tyrelkostyk/GE495-electrical/kicad_project/digitizer/digitizer.kicad_pcb

## KiCad design kicad_project/digitizer/digitizer.kicad_pcb (2022-02-17)

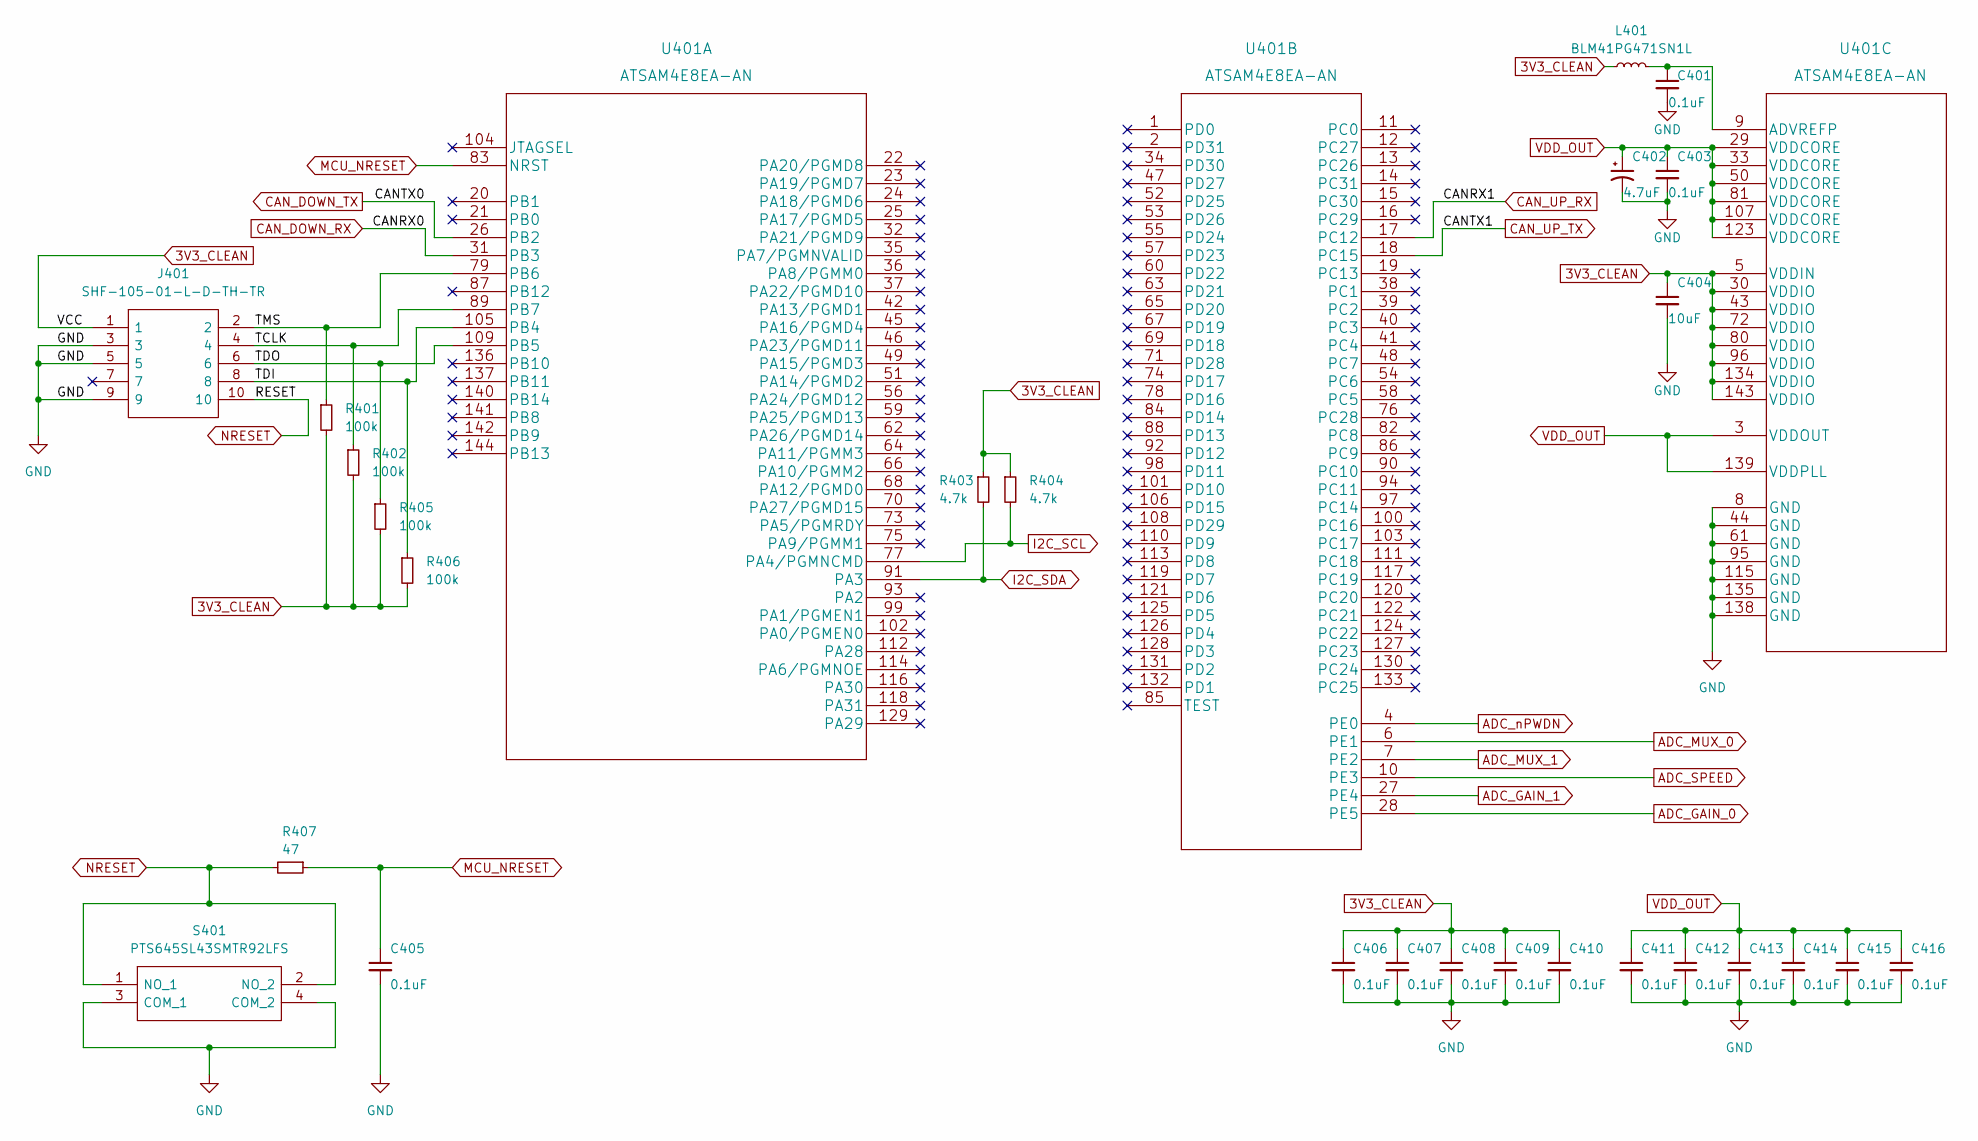
[picture p5: schematic MCU.kicad_sch]

Parts:
C401, C403, C405, C406, C407, C408, C409, C410, C411, C412, C413, C414, C415, C416: 0.1uF; C_0805_2012Metric_Pad1.18x1.45mm_HandSolder
C402: 4.7uF; C_0805_2012Metric_Pad1.18x1.45mm_HandSolder
C404: 10uF; C_0805_2012Metric_Pad1.18x1.45mm_HandSolder
J401: SHF-105-01-L-D-TH-TR; SHF10501LDTHTR; Mouser Part Number 200-SHF10501LDTHTR
L401: BLM41PG471SN1L; L_1806_4516Metric_Pad1.45x1.90mm_HandSolder
R401, R402, R405, R406: 100k; R_0805_2012Metric_Pad1.20x1.40mm_HandSolder
R403, R404: 4.7k; R_0805_2012Metric_Pad1.20x1.40mm_HandSolder
R407: 47; R_0805_2012Metric_Pad1.20x1.40mm_HandSolder
S401: PTS645SL43SMTR92LFS; Mouser Part Number 611-PTS645SL43SMTR92
U401: ATSAM4E8EA-AN

Connections:
3V3_CLEAN: C404.1, C406.1, C407.1, C408.1, C409.1, C410.1, J401.1, L401.1, R401.2, R402.2, R403.1, R404.1, R405.2, R406.2, U401.5 (VDDIN), U401.30 (VDDIO), U401.43 (VDDIO), U401.72 (VDDIO), U401.80 (VDDIO), U401.96 (VDDIO), U401.134 (VDDIO), U401.143 (VDDIO); also elsewhere on the board
/MCU/TCLK: J401.4, R402.1, U401.89 (PB7)
/MCU/TDI: J401.8, R406.1, U401.105 (PB4)
/MCU/TDO: J401.6, R405.1, U401.109 (PB5)
/MCU/TMS: J401.2, R401.1, U401.79 (PB6)
ADC_GAIN_0: U401.28 (PE5); also elsewhere on the board
ADC_GAIN_1: U401.27 (PE4); also elsewhere on the board
ADC_MUX_0: U401.6 (PE1); also elsewhere on the board
ADC_MUX_1: U401.7 (PE2); also elsewhere on the board
ADC_SPEED: U401.10 (PE3); also elsewhere on the board
ADC_nPWDN: U401.4 (PE0); also elsewhere on the board
CAN_DOWN_RX: U401.31 (PB3); also elsewhere on the board
CAN_DOWN_TX: U401.26 (PB2); also elsewhere on the board
CAN_UP_RX: U401.17 (PC12); also elsewhere on the board
CAN_UP_TX: U401.18 (PC15); also elsewhere on the board
GND: C401.2, C402.2, C403.2, C404.2, C405.2, C406.2, C407.2, C408.2, C409.2, C410.2, C411.2, C412.2, C413.2, C414.2, C415.2, C416.2, J401.3, J401.5, J401.9, S401.3 (COM_1), S401.4 (COM_2), U401.8 (GND), U401.44 (GND), U401.61 (GND), U401.95 (GND), U401.115 (GND), U401.135 (GND), U401.138 (GND); also elsewhere on the board
I2C_SCL: R404.2, U401.77 (PA4/PGMNCMD); also elsewhere on the board
I2C_SDA: R403.2, U401.91 (PA3); also elsewhere on the board
MCU_NRESET: C405.1, R407.1, U401.83 (NRST)
NRESET: J401.10, R407.2, S401.1 (NO_1), S401.2 (NO_2)
unnamed: C401.1, L401.2, U401.9 (ADVREFP)
VDD_OUT: C402.1, C403.1, C411.1, C412.1, C413.1, C414.1, C415.1, C416.1, U401.3 (VDDOUT), U401.29 (VDDCORE), U401.33 (VDDCORE), U401.50 (VDDCORE), U401.81 (VDDCORE), U401.107 (VDDCORE), U401.123 (VDDCORE), U401.139 (VDDPLL)

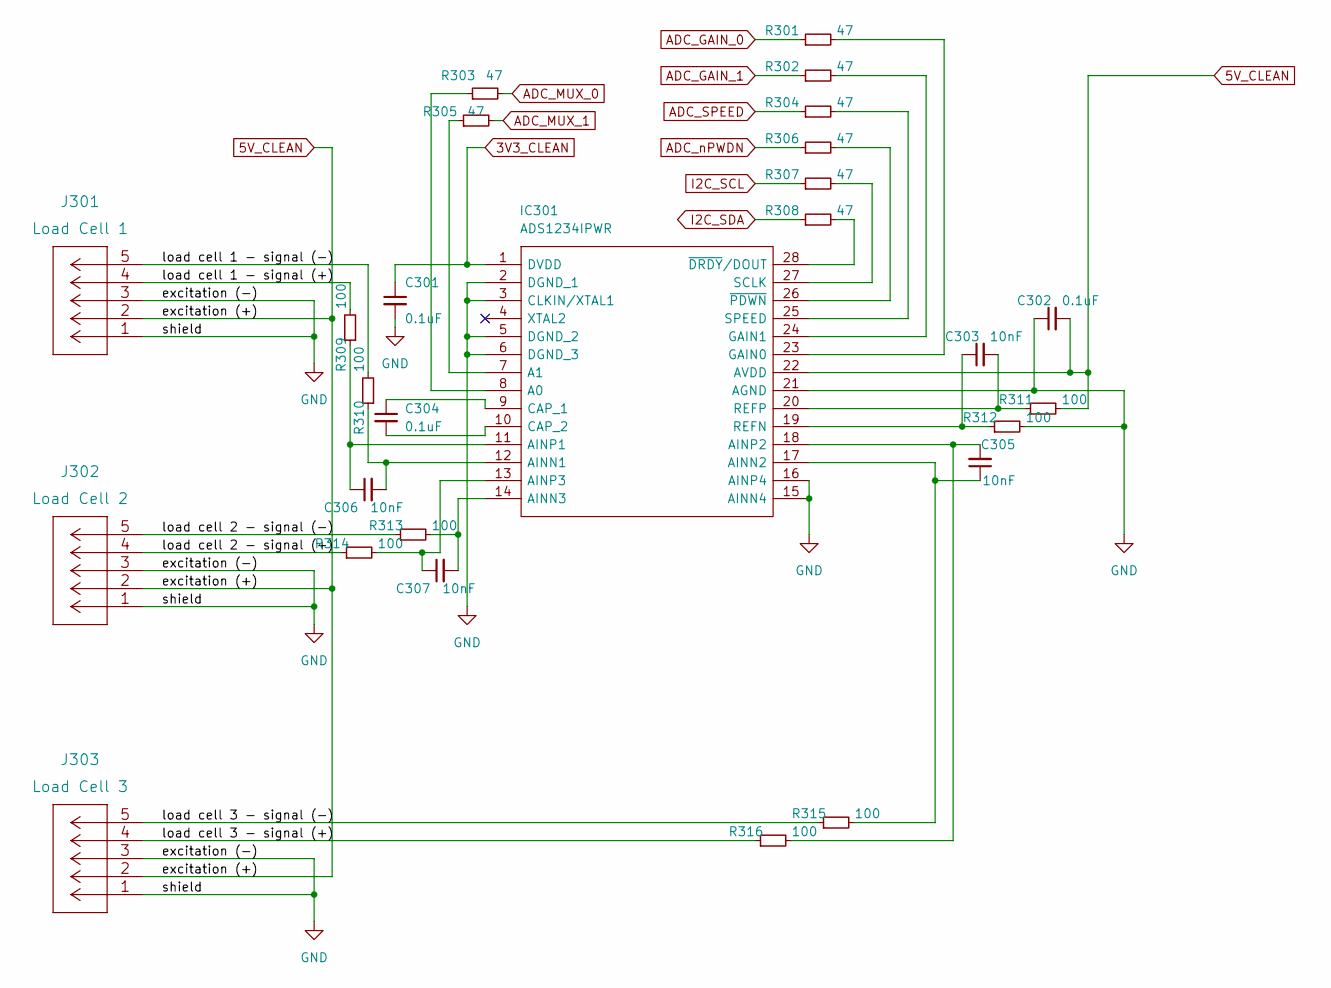
[picture p6: schematic ANALOG.kicad_sch]

Parts:
C301, C302, C304: 0.1uF; C_0805_2012Metric_Pad1.18x1.45mm_HandSolder
C303, C305, C306, C307: 10nF; C_0805_2012Metric_Pad1.18x1.45mm_HandSolder
IC301: ADS1234IPWR; SOP65P640X120-28N; Mouser Part Number 595-ADS1234IPWR
J301: Load Cell 1; 1935190
J302: Load Cell 2; 1935190
J303: Load Cell 3; 1935190
R301, R302, R303, R304, R305, R306, R307, R308: 47; R_0805_2012Metric_Pad1.20x1.40mm_HandSolder
R309, R310, R311, R312, R313, R314, R315, R316: 100; R_0805_2012Metric_Pad1.20x1.40mm_HandSolder

Connections:
3V3_CLEAN: C301.1, IC301.1 (DVDD); also elsewhere on the board
5V_CLEAN: C302.2, IC301.22 (AVDD), J301.2, J302.2, J303.2, R311.2; also elsewhere on the board
/ANALOG/load cell 1 - signal (+): J301.4, R309.2
/ANALOG/load cell 1 - signal (-): J301.5, R310.2
/ANALOG/load cell 2 - signal (+): J302.4, R314.1
/ANALOG/load cell 2 - signal (-): J302.5, R313.1
/ANALOG/load cell 3 - signal (+): J303.4, R316.1
/ANALOG/load cell 3 - signal (-): J303.5, R315.1
ADC_GAIN_0: R301.1; also elsewhere on the board
ADC_GAIN_1: R302.1; also elsewhere on the board
ADC_MUX_0: R303.2; also elsewhere on the board
ADC_MUX_1: R305.2; also elsewhere on the board
ADC_SPEED: R304.1; also elsewhere on the board
ADC_nPWDN: R306.1; also elsewhere on the board
GND: C301.2, C302.1, IC301.2 (DGND_1), IC301.3 (CLKIN/XTAL1), IC301.5 (DGND_2), IC301.6 (DGND_3), IC301.15 (AINN4), IC301.16 (AINP4), IC301.21 (AGND), J301.1, J301.3, J302.1, J302.3, J303.1, J303.3, R312.2; also elsewhere on the board
I2C_SCL: R307.1; also elsewhere on the board
I2C_SDA: R308.1; also elsewhere on the board
unnamed: C303.1, IC301.19 (REFN), R312.1
unnamed: C303.2, IC301.20 (REFP), R311.1
unnamed: C304.1, IC301.9 (CAP_1)
unnamed: C304.2, IC301.10 (CAP_2)
unnamed: C305.1, IC301.17 (AINN2), R315.2
unnamed: C305.2, IC301.18 (AINP2), R316.2
unnamed: C306.1, IC301.11 (AINP1), R309.1
unnamed: C306.2, IC301.12 (AINN1), R310.1
unnamed: C307.1, IC301.13 (AINP3), R314.2
unnamed: C307.2, IC301.14 (AINN3), R313.2
unnamed: IC301.7 (A1), R305.1
unnamed: IC301.8 (A0), R303.1
unnamed: IC301.23 (GAIN0), R301.2
unnamed: IC301.24 (GAIN1), R302.2
unnamed: IC301.25 (SPEED), R304.2
unnamed: IC301.26 (~PDWN), R306.2
unnamed: IC301.27 (SCLK), R307.2
unnamed: IC301.28 (~DRDY/DOUT), R308.2

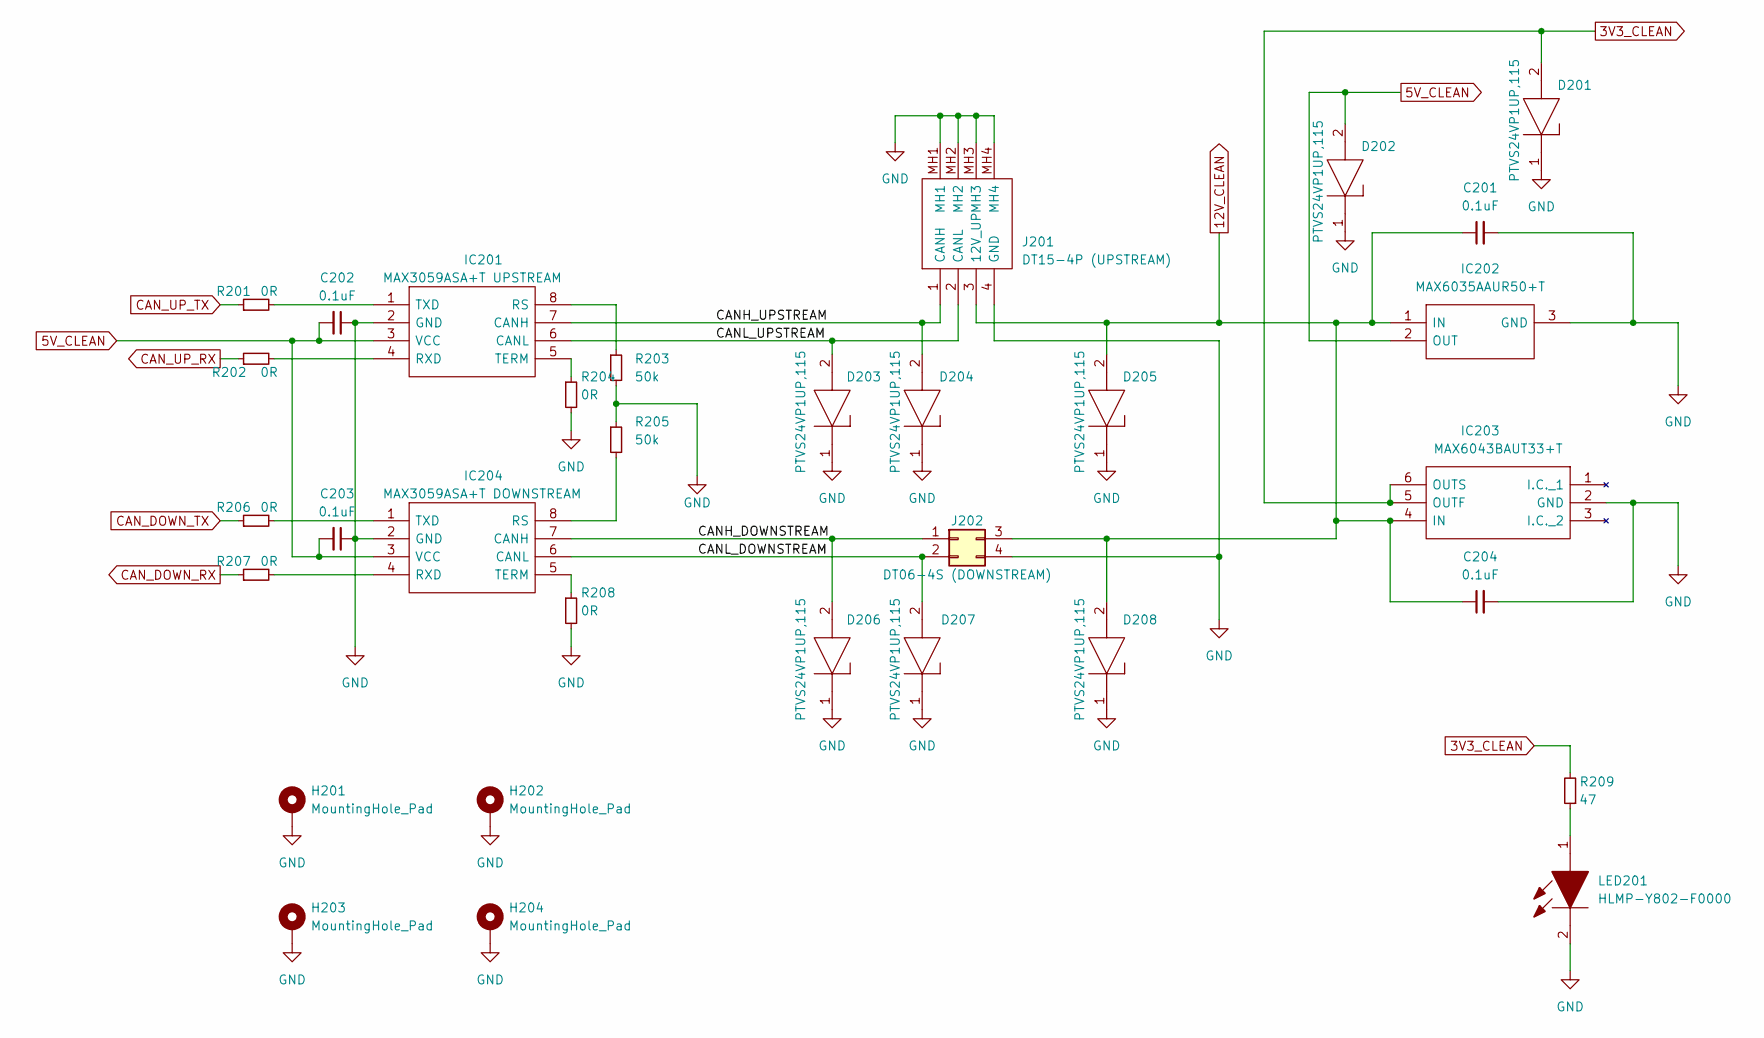
[picture p7: schematic CANPWR.kicad_sch]

Parts:
C201, C202, C203, C204: 0.1uF; C_0805_2012Metric_Pad1.18x1.45mm_HandSolder
D201, D202, D203, D204, D205, D206, D207, D208: PTVS24VP1UP,115; PMEG3050EP115; Mouser Part Number 771-PTVS24VP1UP115
H201, H202, H203, H204: MountingHole_Pad; MountingHole_3.2mm_M3_Pad
IC201: MAX3059ASA+T UPSTREAM; SOIC127P600X175-8N; Mouser Part Number 700-MAX3059ASAT
IC202: MAX6035AAUR50+T; SOT95P237X112-3N; Manufacturer_Part_Number MAX6035AAUR50+T
IC203: MAX6043BAUT33+T; SOT95P280X145-6N; Mouser Part Number 700-MAX6043BAUT33+T
IC204: MAX3059ASA+T DOWNSTREAM; SOIC127P600X175-8N; Mouser Part Number 700-MAX3059ASAT
J201: DT15-4P (UPSTREAM); DT154P; Mouser Part Number 571-DT15-4P
J202: DT06-4S (DOWNSTREAM); 1935187
LED201: HLMP-Y802-F0000; HLMPY802F0000; Mouser Part Number 630-HLMP-Y802-F0000
R201, R202, R204, R206, R207, R208: 0R; R_0805_2012Metric_Pad1.20x1.40mm_HandSolder
R203, R205: 50k; R_0805_2012Metric_Pad1.20x1.40mm_HandSolder
R209: 47; R_0805_2012Metric_Pad1.20x1.40mm_HandSolder

Connections:
3V3_CLEAN: D201.2, IC203.5 (OUTF), IC203.6 (OUTS), R209.2; also elsewhere on the board
5V_CLEAN: C202.2, C203.2, D202.2, IC201.3 (VCC), IC202.2 (OUT), IC204.3 (VCC); also elsewhere on the board
12V_CLEAN: C201.1, C204.1, D205.2, D208.2, IC202.1 (IN), IC203.4 (IN), J201.3 (12V_UP), J202.3 (12V_DOWN)
/CANPWR/CANH_DOWNSTREAM: D206.2, IC204.7 (CANH), J202.1 (CAN1)
/CANPWR/CANH_UPSTREAM: D204.2, IC201.7 (CANH), J201.1 (CANH)
/CANPWR/CANL_DOWNSTREAM: D207.2, IC204.6 (CANL), J202.2 (CANL)
/CANPWR/CANL_UPSTREAM: D203.2, IC201.6 (CANL), J201.2 (CANL)
CAN_DOWN_RX: R207.1; also elsewhere on the board
CAN_DOWN_TX: R206.1; also elsewhere on the board
CAN_UP_RX: R202.1; also elsewhere on the board
CAN_UP_TX: R201.1; also elsewhere on the board
GND: C201.2, C202.1, C203.1, C204.2, D201.1, D202.1, D203.1, D204.1, D205.1, D206.1, D207.1, D208.1, H201.1, H202.1, H203.1, H204.1, IC201.2 (GND), IC202.3 (GND), IC203.2 (GND), IC204.2 (GND), J201.4 (GND), J201.MH1, J201.MH2, J201.MH3, J201.MH4, J202.4 (GND), LED201.2, R203.2, R204.2, R205.1, R208.2; also elsewhere on the board
unnamed: IC201.1 (TXD), R201.2
unnamed: IC201.4 (RXD), R202.2
unnamed: IC201.5 (TERM), R204.1
unnamed: IC201.8 (RS), R203.1
unnamed: IC204.1 (TXD), R206.2
unnamed: IC204.4 (RXD), R207.2
unnamed: IC204.5 (TERM), R208.1
unnamed: IC204.8 (RS), R205.2
unnamed: LED201.1, R209.1

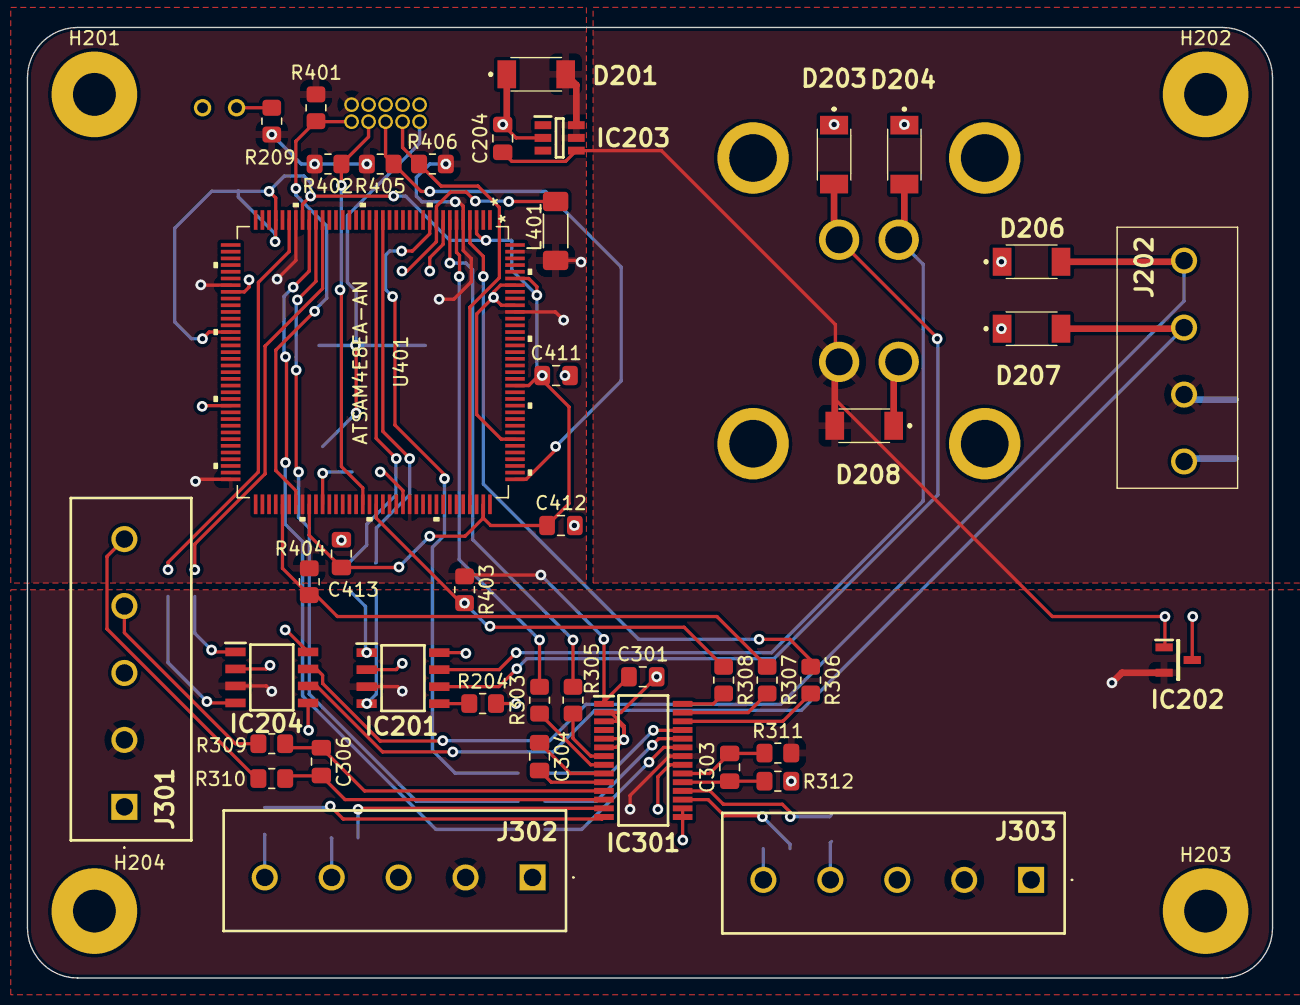
[picture p8: board digitizer.kicad_pcb from above]

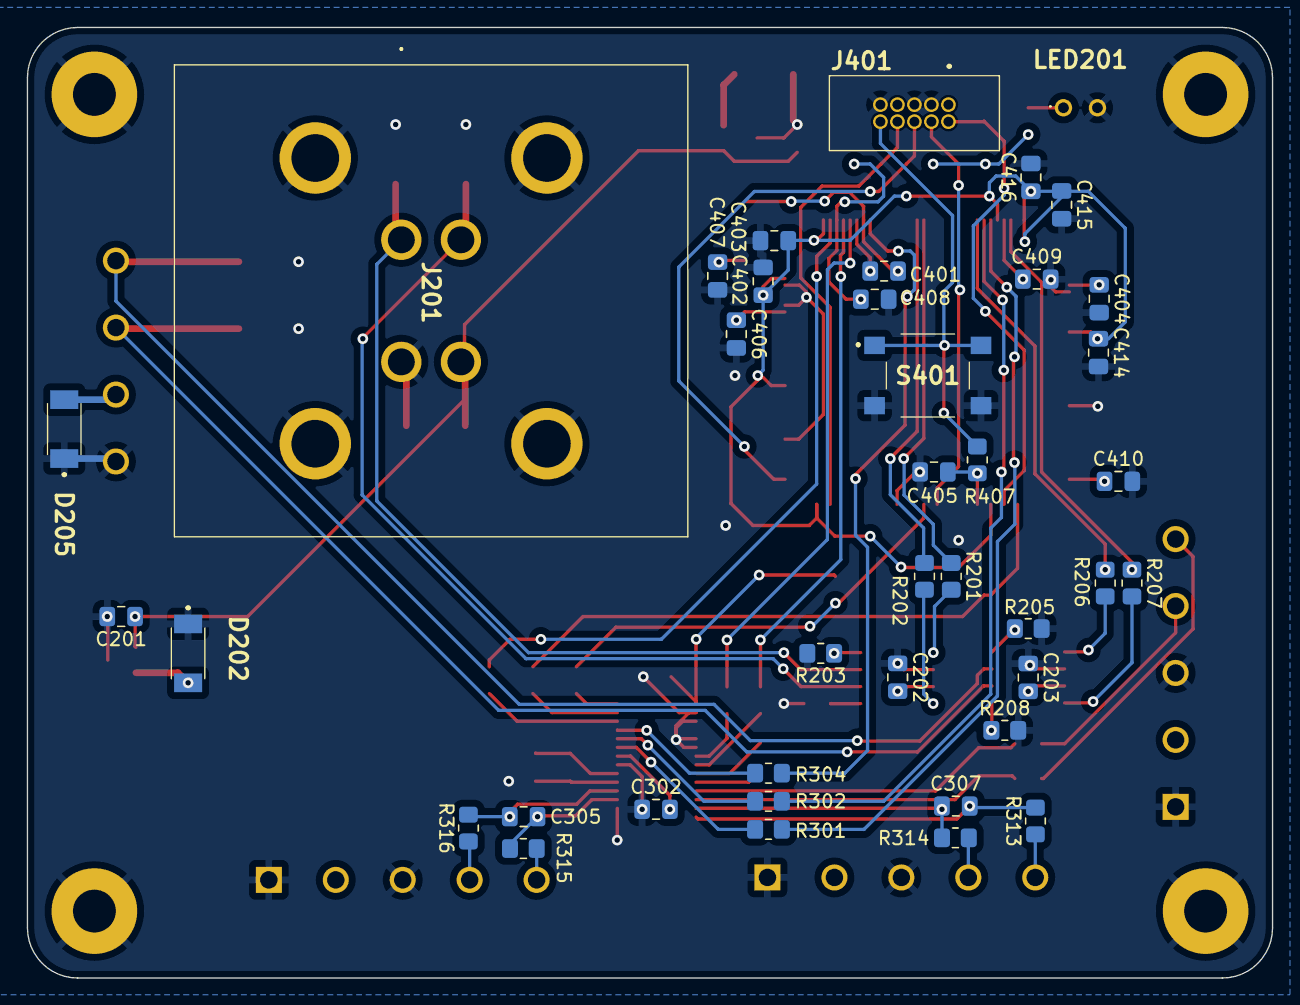
[picture p9: board digitizer.kicad_pcb from below]

Board: 2 copper layers, 93.0 x 71.0 mm, 86 parts (40 on the bottom side), 61 nets.
