tyrelkostyk/GE495-electrical/(commit log)

2022-01-15 created project; not sure if certain files should be ignored or included
    [digitizer.kicad_pcb, digitizer.kicad_sch]
2022-01-15 created footprint and symbol project library for our project; started work on the new symbol
2022-01-16 finished schematic symbol for the LPC1813JBD144, and connected it to the LQFP144 footprint! Placed it into the schematic
    [digitizer.kicad_sch]
2022-01-16 divided schematic up into 3 sheets, and placed the corresponding components within them. Have not connected anything or match the correct connectors to the proper footprints yet
    [ANALOG.kicad_sch, CANPWR.kicad_sch, MCU.kicad_sch, digitizer.kicad_sch]
2022-01-17 finished the CANPWR sheet, got to work on the MCU sheet (finished the CAN stuff). Good progress; still missing the MCU pin connections and the connector footprints (M12, deutsch, etc.)
    [ANALOG.kicad_sch, CANPWR.kicad_sch, MCU.kicad_sch, digitizer.kicad_sch]
2022-01-20 imported the correct symbols & footprints, and added a few to the schematic: pulled in the correct MCU symbol/footprint, as well as the correct JTAG footprint (connected to the 2x5 odd_even connector)
    [MCU.kicad_sch, digitizer.kicad_sch]
2022-01-28 moved CAN modules to the CANPWR sheet. Finished (first draft) of the MCU power design
    [CANPWR.kicad_sch, MCU.kicad_sch, digitizer.kicad_sch]
2022-01-28 updated annotations
    [CANPWR.kicad_sch, MCU.kicad_sch, digitizer.kicad_sch]
2022-01-28 added global flags to connect the MCU CAN lines with the CAN Transceivers
    [MCU.kicad_sch]
2022-01-28 connected the ADC I2C lines
    [ANALOG.kicad_sch, MCU.kicad_sch, digitizer.kicad_sch]
2022-01-29 added the JTAG and Reset circuitry
    [MCU.kicad_sch, digitizer.kicad_sch]
2022-01-30 fixed the reset switch circuitry, added labels to CAN lines
    [MCU.kicad_sch, digitizer.kicad_sch]
2022-01-31 added GPIO lines, LED, other small changes
    [ANALOG.kicad_sch, CANPWR.kicad_sch, MCU.kicad_sch, digitizer.kicad_sch]
2022-01-31 added proper connector symbols and footprints for M12 and DT15 (digital upstream) connectors
    [ANALOG.kicad_sch, CANPWR.kicad_sch, MCU.kicad_sch, digitizer.kicad_sch]
2022-02-13 updated schematic to include terminal blocks for the analog M12 connectors and the downstream CANPWR connector
    [ANALOG.kicad_sch, CANPWR.kicad_sch, MCU.kicad_sch, digitizer.kicad_sch]
2022-02-14 cleared ALL errors from electrical rules check; had to explicitly define a bunch of pins, and remove a few bugs (shorted lines, etc.)
    [ANALOG.kicad_sch, CANPWR.kicad_sch, MCU.kicad_sch, digitizer.kicad_sch]
2022-02-14 removed unneccesary no-connects
    [CANPWR.kicad_sch]
2022-02-14 fixed another small bug; looks good to begin the board layout!
    [MCU.kicad_sch]
2022-02-14 updated a name
    [ANALOG.kicad_sch, CANPWR.kicad_sch, MCU.kicad_sch, digitizer.kicad_sch]
2022-02-14 created edge layer! Was harder than expected haha
    [digitizer.kicad_pcb]
2022-02-14 re-did the edges for the PCB; now has the correct radius of curvature for the corners (3.75mm)
    [digitizer.kicad_pcb]
2022-02-14 placed deutsch connector and 1 mounting hole; the former at the exact spot according to Isaac's specs, and the second at a slightly custom spot (see discord #mechanical channel for details)
    [digitizer.kicad_pcb]
2022-02-14 placed the rest of the mounting holes at my chosen location (each hole is 5mm from each x/y edge)
    [digitizer.kicad_pcb]
2022-02-14 placed all of the connectors and ICs in their initial spots/sides
    [digitizer.kicad_pcb]
2022-02-14 added a ground plane
    [digitizer.kicad_pcb]
2022-02-14 added 5pin term blocks for the M12 connections, so we can properly ground the shield connections
    [ANALOG.kicad_sch, digitizer.kicad_pcb, digitizer.kicad_sch]
2022-02-14 added plane for 5V clean on the F.Cu layer
    [digitizer.kicad_pcb]
2022-02-14 added 12V_CLEAN label to schematic; added planes for 12V_CLEAN and 3V3_CLEAN to layout
    [ANALOG.kicad_sch, CANPWR.kicad_sch, MCU.kicad_sch, digitizer.kicad_pcb]
2022-02-14 updated copper zones to properly connect to tiny solder pads
    [digitizer.kicad_pcb]
2022-02-14 placed & routed bypass capacitors for both power regulators
    [digitizer.kicad_pcb]
2022-02-14 routed LED connections; replaced 12V_CLEAN copper zone so it was one consecutive zone instead of 2 separate zones
    [digitizer.kicad_pcb]
2022-02-14 moved a few things around
    [digitizer.kicad_pcb]
2022-02-14 finished ADC routing, including MCU pins (MUX, I2C, etc.)
    [ANALOG.kicad_sch, digitizer.kicad_pcb]
2022-02-15 backup commit; going to change all of the capacitor and resistor sizes to be much smaller
    [digitizer.kicad_pcb]
2022-02-15 updated schematic to use all 0805 parts (both caps and resistors)
    [ANALOG.kicad_sch, CANPWR.kicad_sch, MCU.kicad_sch, digitizer.kicad_pcb, digitizer.kicad_sch]
2022-02-15 updated layout with new, smaller passive components
    [digitizer.kicad_pcb]
2022-02-15 continued layout progress; connected JTAG connector and reset switch, among a few other changes
    [digitizer.kicad_pcb]
2022-02-15 more progress! CAN ICs are done, just the MCU Power decoupling is left
    [digitizer.kicad_pcb]
2022-02-15 modified the power planes so that the 12V plane routes above the 3V3 plane, not below it (thus making the space below the MCU less crowded). Also completed some further connections
    [digitizer.kicad_pcb]
2022-02-15 progress on connecting PWR/GND pins
    [digitizer.kicad_pcb]
2022-02-15 more progress; finished connecting all passives and components except for MCU power pins
    [digitizer.kicad_pcb]
2022-02-15 added 100ohm resistors to the differential analog inputs
    [ANALOG.kicad_sch, digitizer.kicad_pcb, digitizer.kicad_sch]
2022-02-15 finished GND (i think) and VDDCORE/VDDOUT pins
    [digitizer.kicad_pcb]
2022-02-15 placed all of the components!
    [digitizer.kicad_pcb]
2022-02-15 some refinements, fixed a few missing connections
    [digitizer.kicad_pcb]
2022-02-15 properly added mounting holes, drew proper dimension lines
    [CANPWR.kicad_sch, digitizer.kicad_pcb, digitizer.kicad_sch]
2022-02-15 resolved all errors and warnings (ran DRC) for the PCB Layout
    [digitizer.kicad_pcb]
2022-02-15 cleaned up a few more things
    [digitizer.kicad_pcb]
2022-02-15 generated output fab files
    [digitizer-B_Cu.gbr, digitizer-B_Mask.gbr, digitizer-B_Silkscreen.gbr, digitizer-Edge_Cuts.gbr, digitizer-F_Cu.gbr, digitizer-F_Mask.gbr, digitizer-F_Silkscreen.gbr, digitizer-NPTH.drl]
2022-02-16 generated gerbers (put in ZIP), generated STEP file
2022-02-16 moved downstream connector to other side of board; flipped other connectors so they're easier to use; generated new .STEP file
    [digitizer.kicad_pcb]
2022-02-17 added some 0R resistors to pads to allow for easier board modding
    [ANALOG.kicad_sch, CANPWR.kicad_sch, MCU.kicad_sch, digitizer.kicad_sch]
2022-02-17 added TVS diodes to upstream and downstream connector signals
    [CANPWR.kicad_sch, digitizer.kicad_sch]
2022-02-17 added TVS diodes to 3V3 and 5V rails as well
    [CANPWR.kicad_sch, digitizer.kicad_sch]
2022-02-17 fixed everything up
    [MCU.kicad_sch, digitizer.kicad_pcb, digitizer.kicad_sch]
2022-02-17 updated output files
    [digitizer-B_Cu.gbr, digitizer-B_Mask.gbr, digitizer-B_Silkscreen.gbr, digitizer-Edge_Cuts.gbr, digitizer-F_Cu.gbr, digitizer-F_Mask.gbr, digitizer-F_Silkscreen.gbr, digitizer-NPTH.drl]
